tarkin96/EmbeddedSystems_BackBreakers/Hardware/Schematics/README.txt

Team: Back Breakers
Team Mebers: Joe Hilbert, Keven Fuentes, Wade King
Repo URL: buffet@buffet.cs.clemson.edu:kfuente/BackBreakers-CPSC4820
