tarkin96/EmbeddedSystems_BackBreakers/Hardware/Schematics/RFID_System_Board.brd

## EAGLE design Hardware/Schematics/RFID_System_Board.brd (2018-05-08)

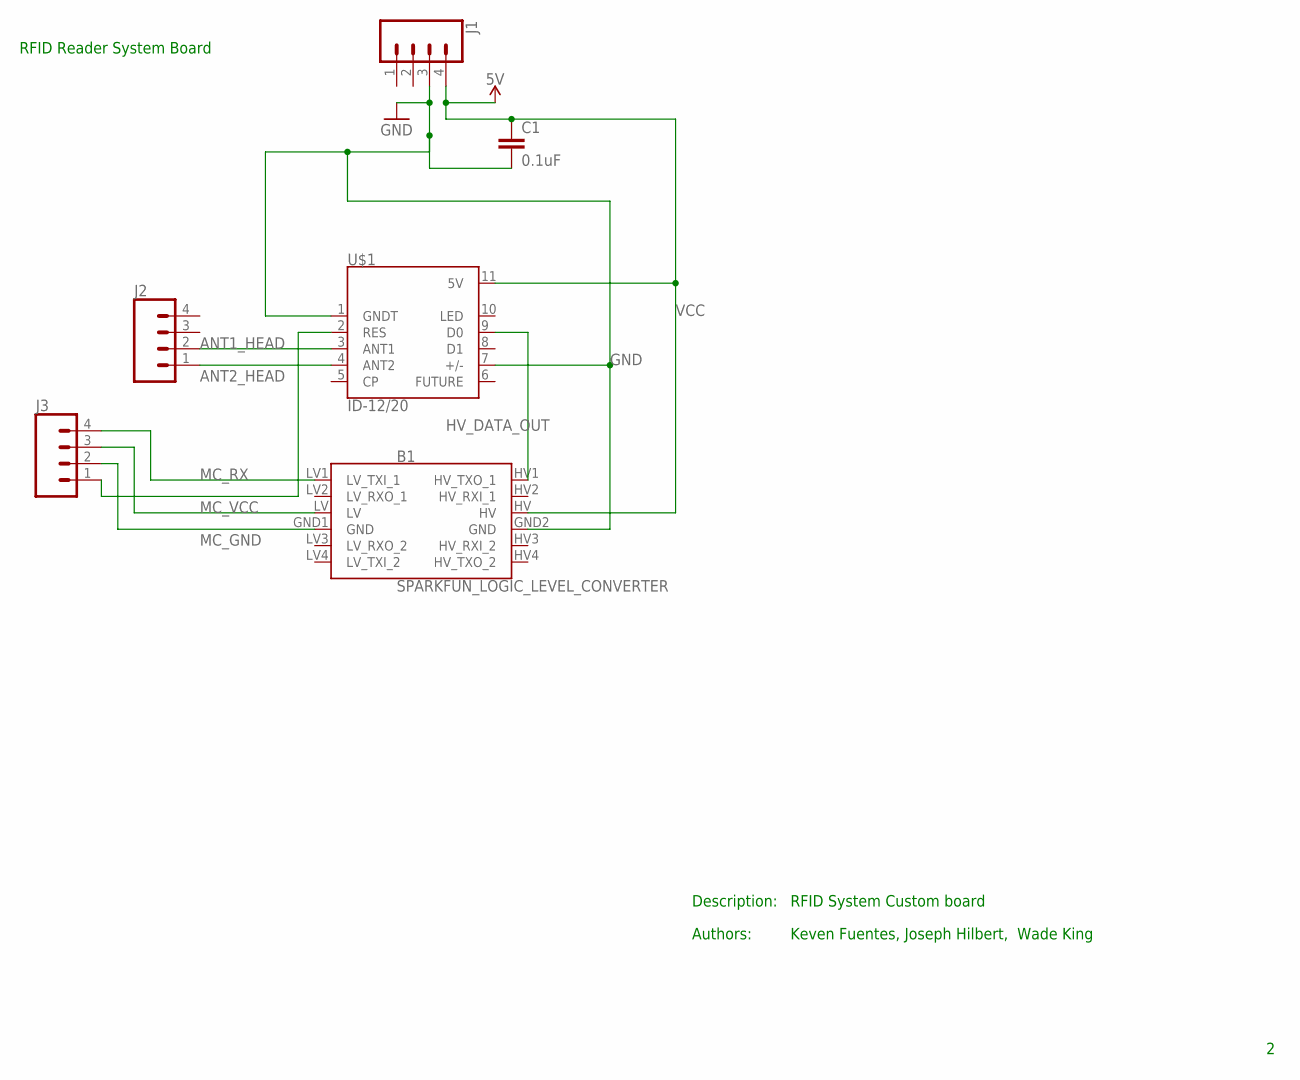
[picture p3: schematic RFID_System_Board.sch]

Parts:
B1: SPARKFUN_LOGIC_LEVEL_CONVERTER
C1: 0.1uF; 0603
J1, J2, J3: CONN_04; 1X04
U$1: ID-12/20; ID-12

Connections:
ANT1_HEAD: J2.2, U$1.3 (ANT1)
ANT2_HEAD: J2.1, U$1.4 (ANT2)
GND: B1.GND2 (GND), C1.2, J1.3, U$1.1 (GNDT), U$1.7 (+/-)
HV_DATA_OUT: B1.HV1 (HV_TXO_1), U$1.9 (D0)
MC_GND: B1.GND1 (GND), J3.2
MC_RX: B1.LV1 (LV_TXI_1), J3.4
MC_VCC: B1.LV, J3.3
unnamed: J3.1, U$1.2 (RES)
VCC: B1.HV, C1.1, J1.4, U$1.11 (5V)

Notes on the sheet:
RFID Reader System Board
RFID System Custom board
Keven Fuentes, Joseph Hilbert, Wade King
Description:
Authors:

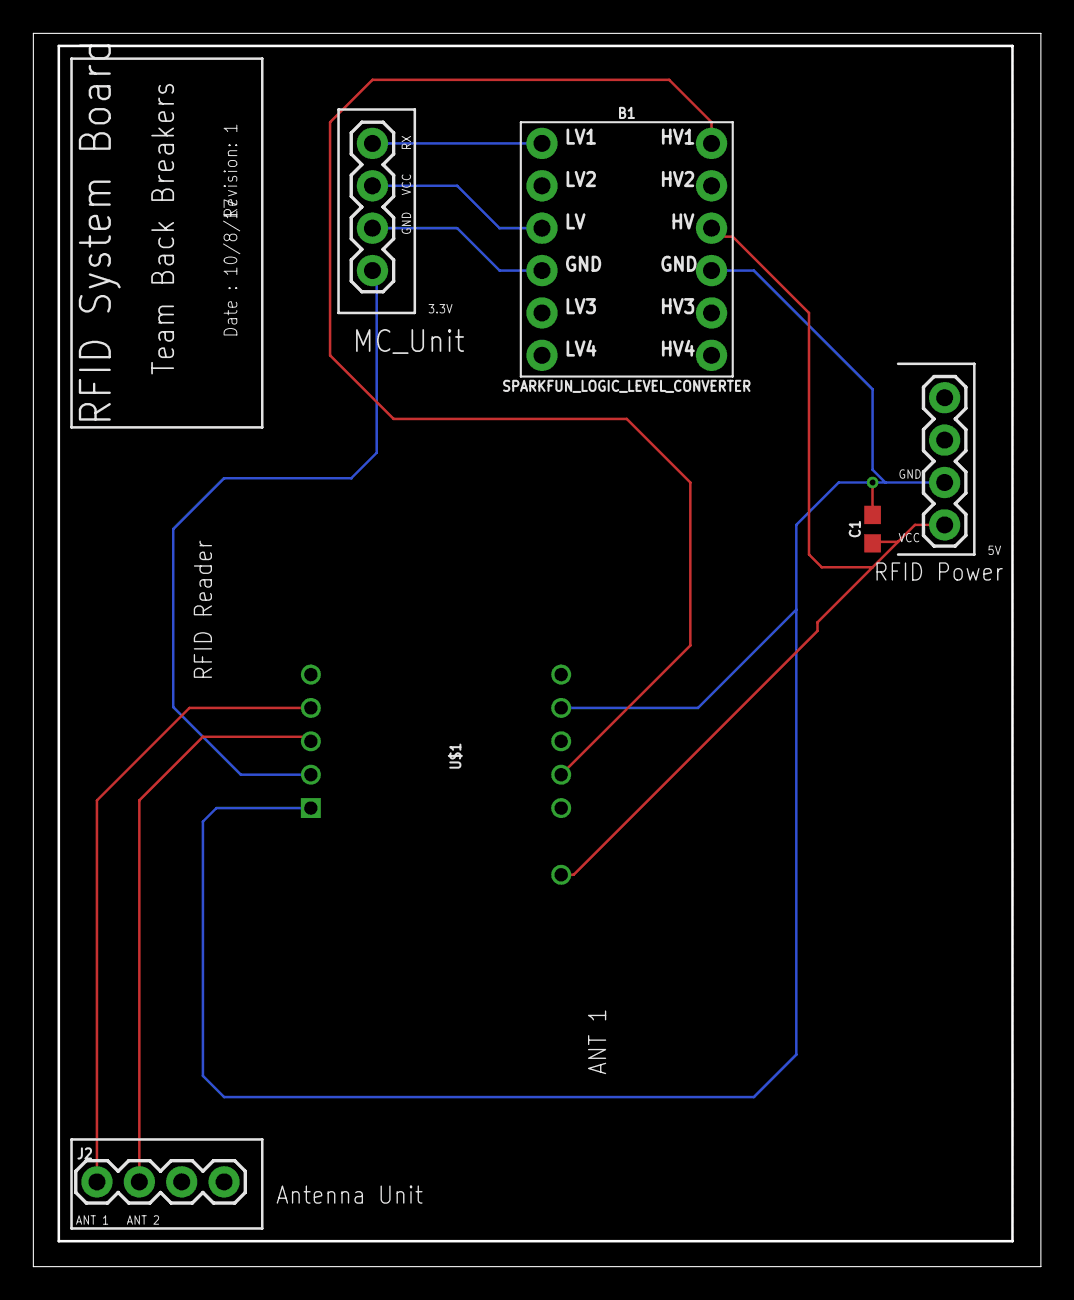
[picture p4: board RFID_System_Board.brd from above]

Board: 2 copper layers, 60.4 x 73.9 mm, 6 parts (0 on the bottom side), 9 nets.
