tarkin96/EmbeddedSystems_BackBreakers/Hardware/Schematics/Speaker_System_Board.brd

## EAGLE design Hardware/Schematics/Speaker_System_Board.brd (2018-05-08)

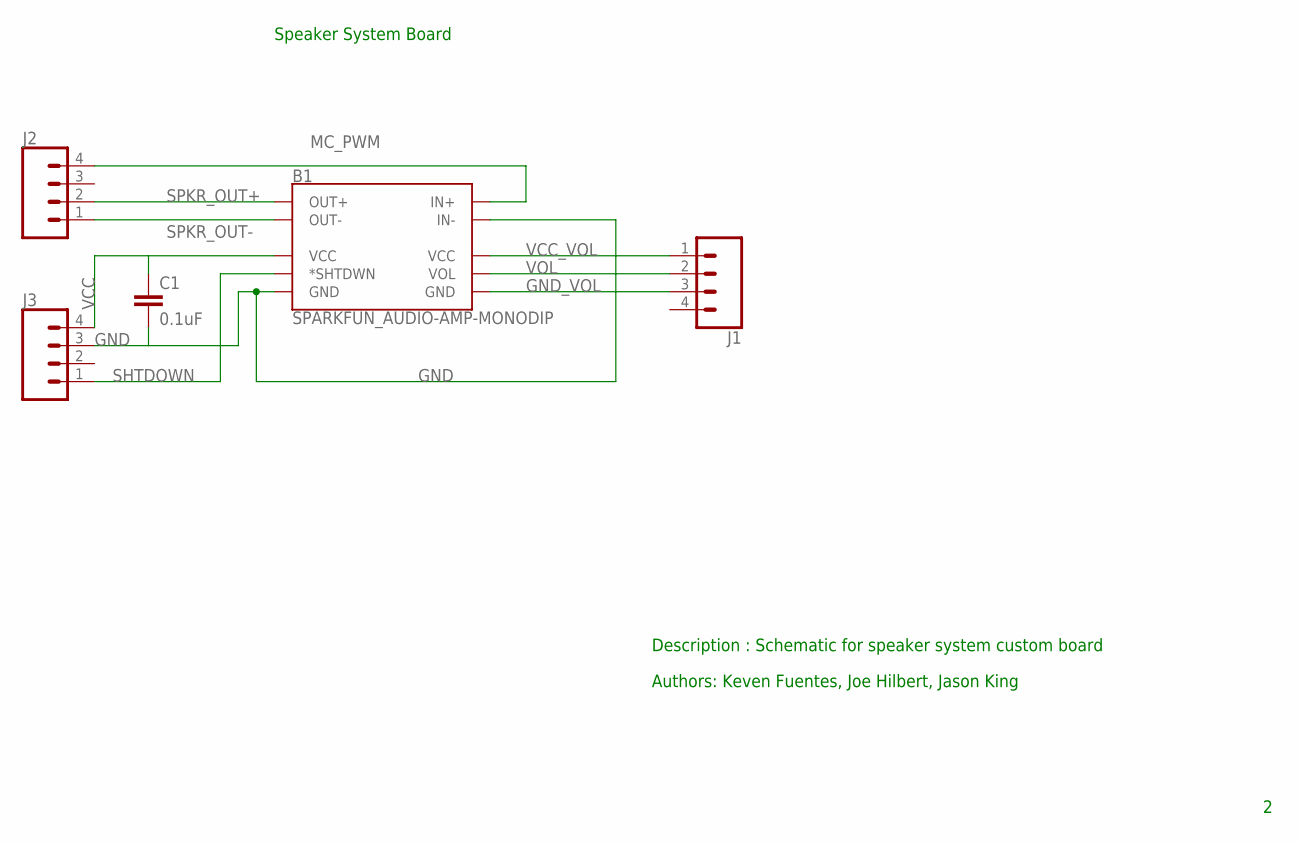
[picture p5: schematic Speaker_System_Board.sch]

Parts:
B1: SPARKFUN_AUDIO-AMP-MONODIP; AUDIO-AMP-MONO
C1: 0.1uF; 0603
J1, J2, J3: CONN_04; 1X04

Connections:
GND: B1.IN-, B1.PWR- (GND), C1.2, J3.3
GND_VOL: B1.VOL- (GND), J1.3
MC_PWM: B1.IN+, J2.4
SHTDOWN: B1.S (*SHTDWN), J3.1
SPKR_OUT+: B1.OUT+, J2.2
SPKR_OUT-: B1.OUT-, J2.1
VCC: B1.PWR+ (VCC), C1.1, J3.4
VCC_VOL: B1.VOL+ (VCC), J1.1
VOL: B1.VOL, J1.2

Notes on the sheet:
Speaker System Board
Description : Schematic for speaker system custom board
Authors: Keven Fuentes, Joe Hilbert, Jason King

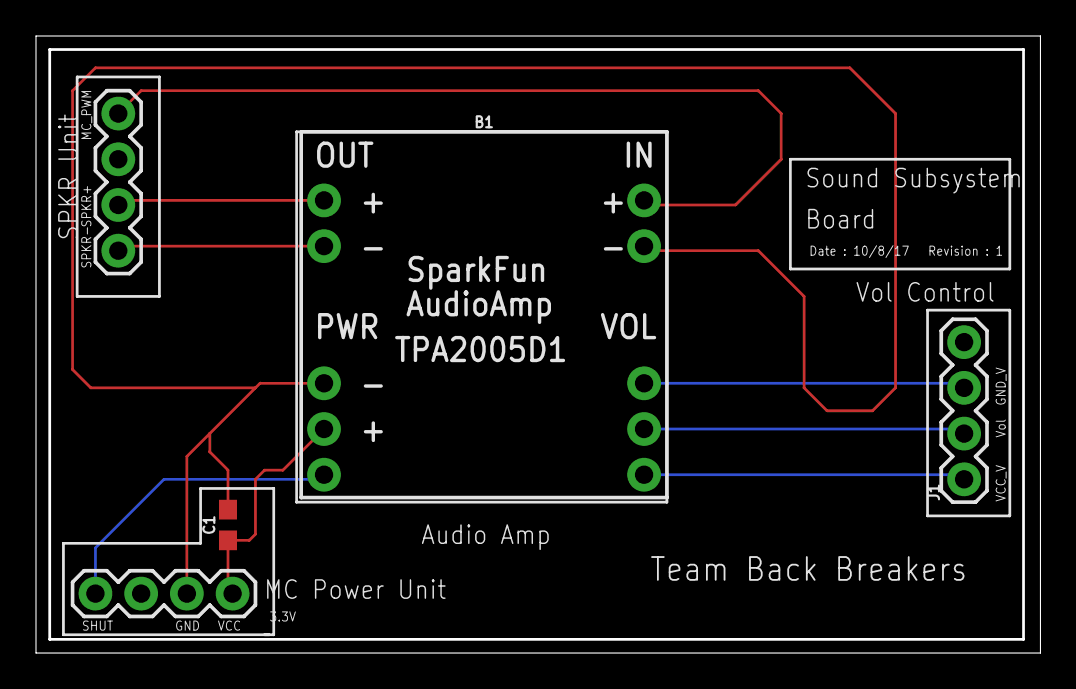
[picture p6: board Speaker_System_Board.brd from above]

Board: 2 copper layers, 55.8 x 34.3 mm, 5 parts (0 on the bottom side), 9 nets.
