tarkin96/EmbeddedSystems_BackBreakers/Hardware/Schematics/CustomHardwareSchematic.brd

## EAGLE design Hardware/Schematics/CustomHardwareSchematic.brd (2018-05-08)

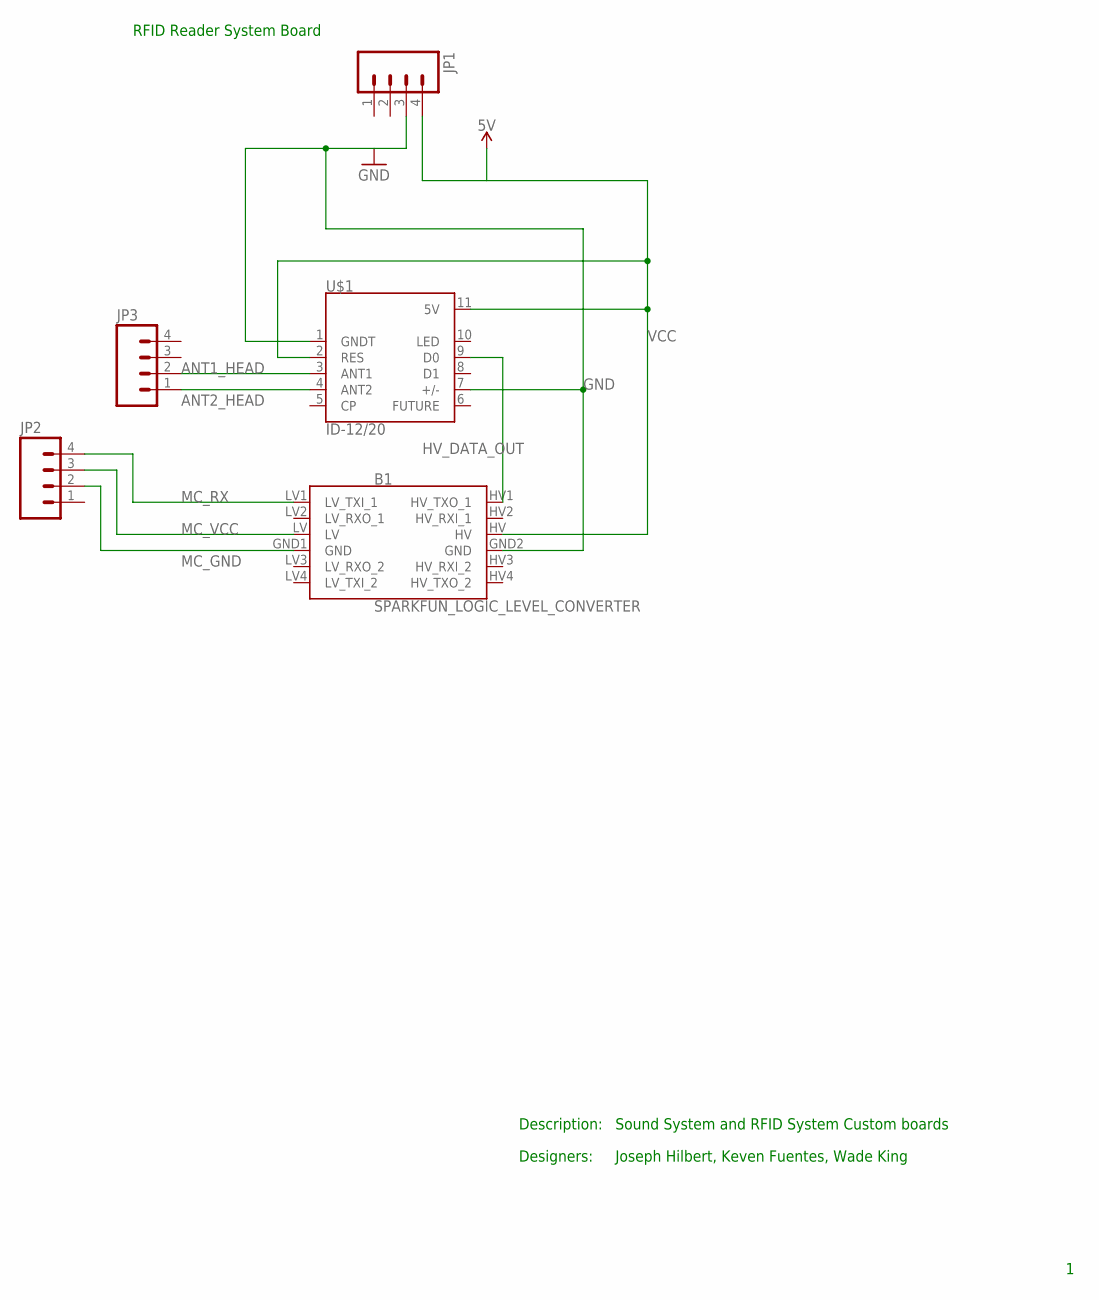
[picture p7: schematic CustomHardwareSchematic.sch]

Parts:
B1: SPARKFUN_LOGIC_LEVEL_CONVERTER
JP1, JP2, JP3: M04LOCK; 1X04_LOCK
U$1: ID-12/20; ID-12

Connections:
ANT1_HEAD: JP3.2, U$1.3 (ANT1)
ANT2_HEAD: JP3.1, U$1.4 (ANT2)
GND: B1.GND2 (GND), JP1.3, U$1.1 (GNDT), U$1.7 (+/-)
HV_DATA_OUT: B1.HV1 (HV_TXO_1), U$1.9 (D0)
MC_GND: B1.GND1 (GND), JP2.2
MC_RX: B1.LV1 (LV_TXI_1), JP2.4
MC_VCC: B1.LV, JP2.3
VCC: B1.HV, JP1.4, U$1.2 (RES), U$1.11 (5V)

Notes on the sheet:
RFID Reader System Board
Sound System and RFID System Custom boards
Joseph Hilbert, Keven Fuentes, Wade King
Description:
Designers:

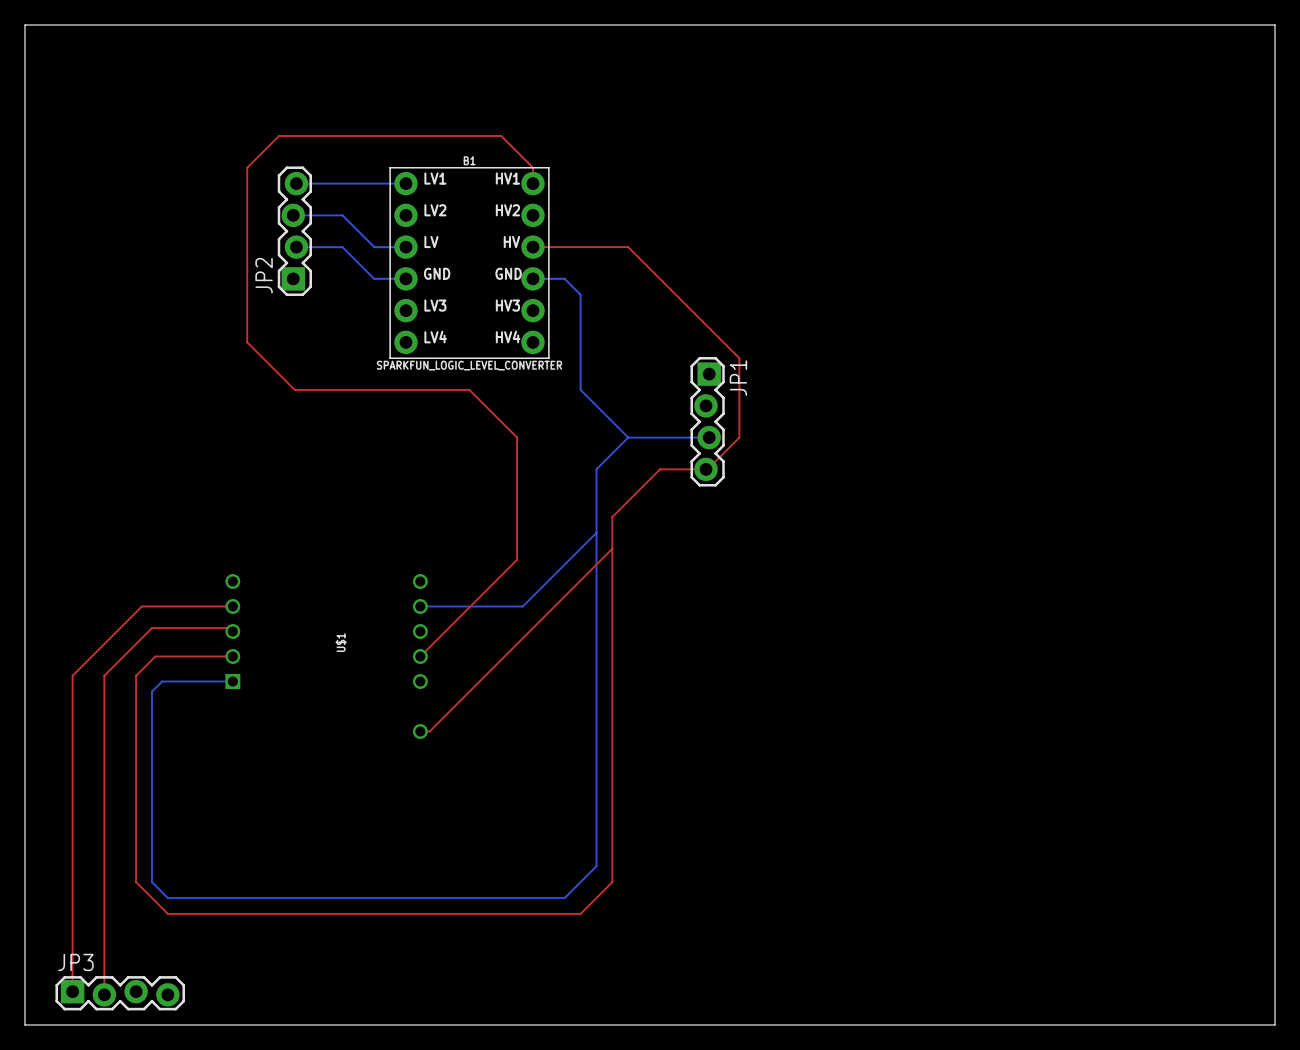
[picture p8: board CustomHardwareSchematic.brd from above]

Board: 2 copper layers, 100.0 x 80.0 mm, 5 parts (0 on the bottom side), 8 nets.
